MOE-MK/turbo-frames/docs/img/og.png

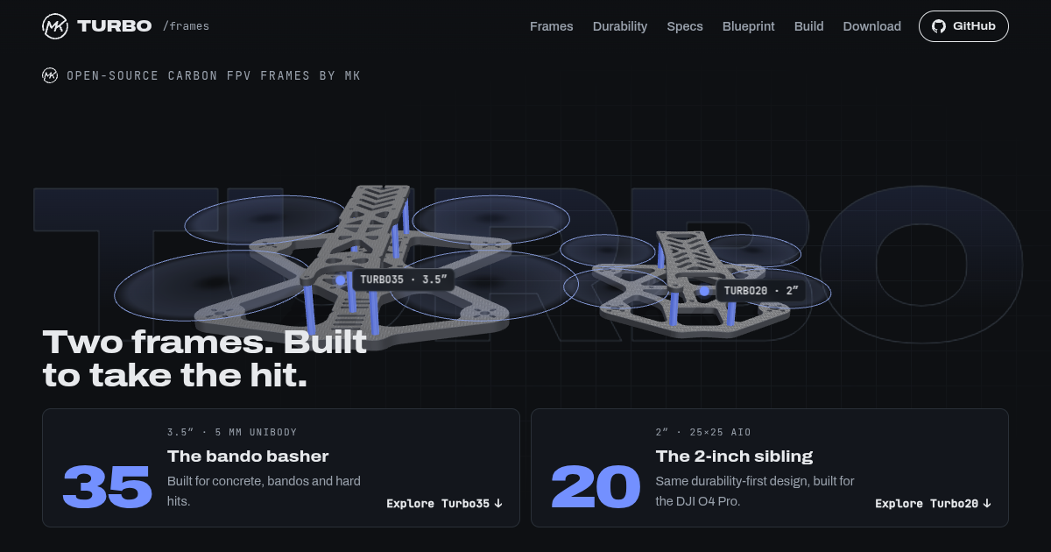
docs/img/og.png
