MOE-MK/turbo-frames/BOM.md

# Bill of Materials

## Turbo35

**Frame weight:** 75 g · **With hardware:** 85 g

| Qty | Part |
|---|---|
| 1 | 5.0 mm base plate (T700), [`dxf/Turbo35_Bottom.dxf`](dxf/Turbo35_Bottom.dxf) |
| 1 | 3.0 mm top plate (T700), [`dxf/Turbo35_Top.dxf`](dxf/Turbo35_Top.dxf) |
| 10 | M2 × 25 mm standoffs |
| 20 | M2 × 8 mm button-head screws |
| 20 | M2 × 10 mm button-head screws |
| 4 | M2 × 20 mm button-head screws |
| 12 | M2 nuts (black) |

**Hole reference (bottom plate)**
- Motor mounts: slotted, fit 9×9 and 12×12 motor patterns (M2)
- Center stack: 20×20 (M2), 30.5×30.5 (3.5 mm holes, M3 clearance), 25.5×25.5 rotated 45° (M2)
- Rear mounting area: 20×20 and 25.5×25.5 (M2)
- Antenna: slot at the back of the top plate

**3D-printed parts:** see [`prints/`](prints/)

## Turbo20

| Qty | Part |
|---|---|
| 1 | 3 mm bottom plate (T700), [`dxf/Turbo20_Bottom.dxf`](dxf/Turbo20_Bottom.dxf) |
| 1 | 2 mm top plate (T700), [`dxf/Turbo20_Top.dxf`](dxf/Turbo20_Top.dxf) |
| — | M2 standoffs and hardware (list coming soon) |

**Recommended electronics:** 12xx–14xx motors at 4000–6000 KV on 4S HV 400–850 mAh.
**Designer's build:** 1303.5 5500 KV motors on a 4S 450 mAh HV pack.

**Hole reference (bottom plate)**
- Motor mounts: 9×9 (M2)
- Stack: 25.5×25.5 rotated 45° (M2), for the 25×25 AIO with the VTX stacked on top
