MOE-MK/turbo-frames/docs/files/dxf/Turbo35_Bottom.dxf

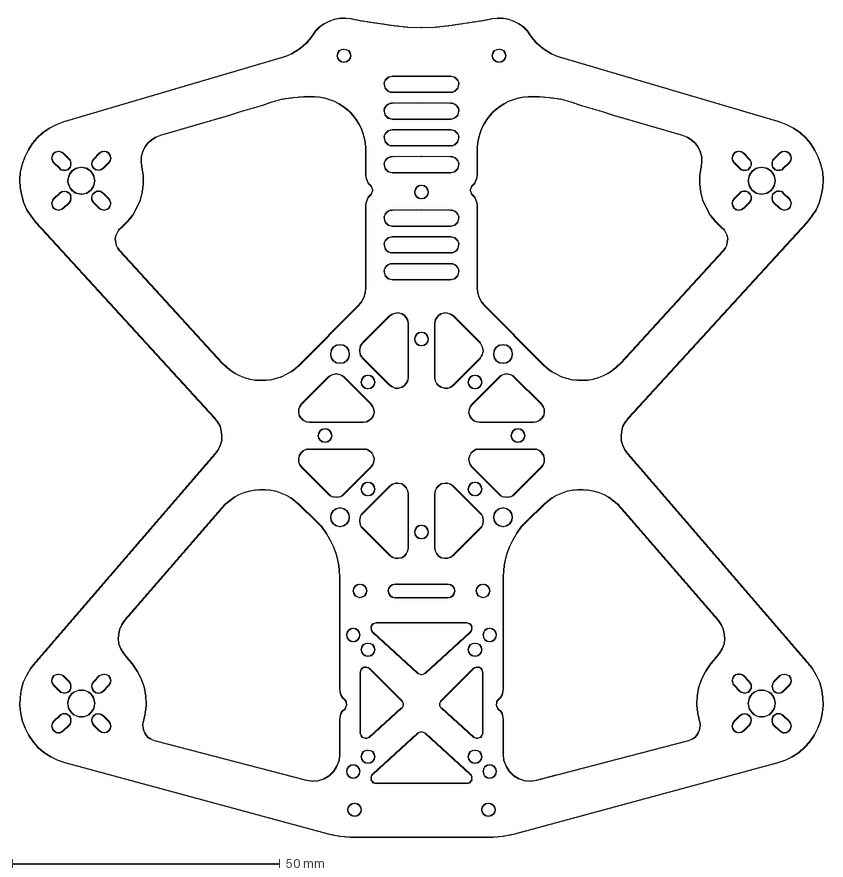
[picture p5: CAD file, 2026-09-28]
docs/files/dxf/Turbo35_Bottom.dxf
151.5 x 153.4 mm
