MOE-MK/turbo-frames/docs/files/prints/o3-cam.stl

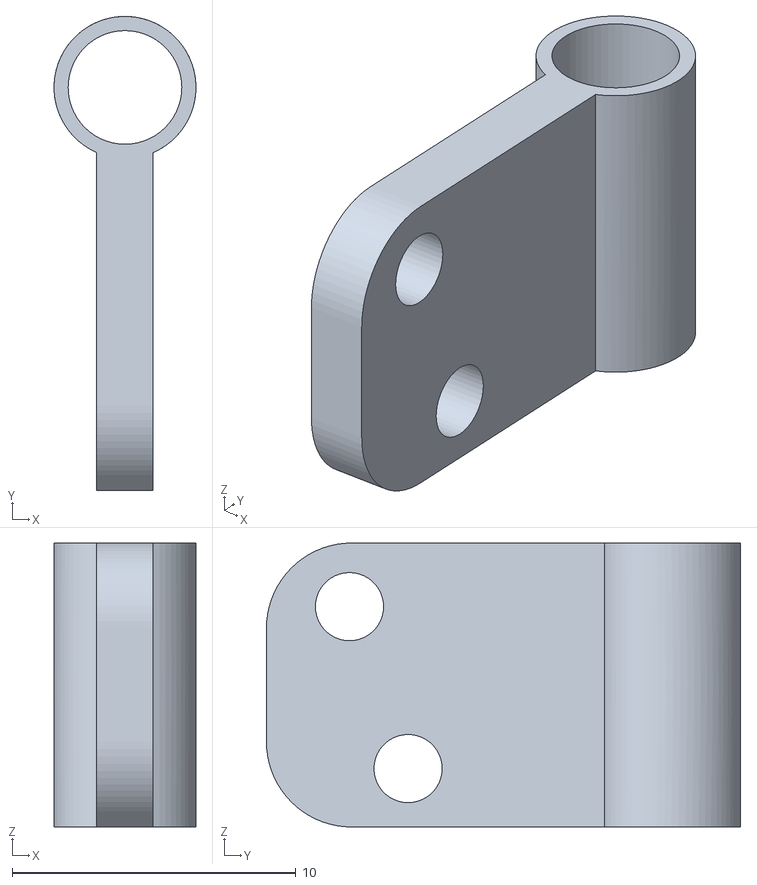
[picture p6: CAD file, 2026-09-28]
docs/files/prints/o3-cam.stl
5.00 x 16.7 x 10.0
