MOE-MK/turbo-frames/prints/turbo35/turbo-35-battery-pad.3mf

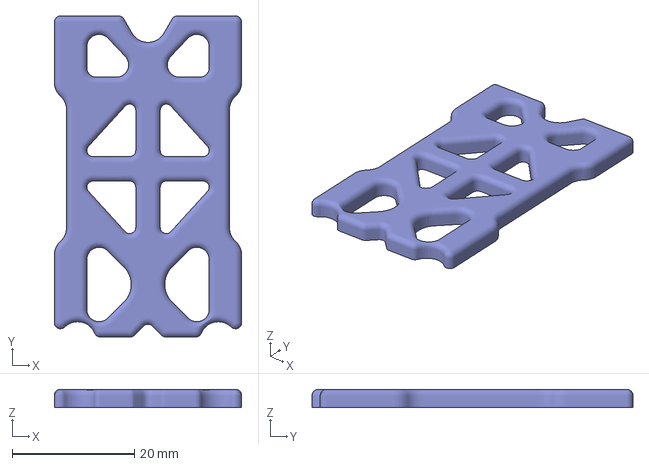
[picture p7: CAD file, 2026-09-28]
prints/turbo35/turbo-35-battery-pad.3mf
30.6 x 52.5 x 3.00 mm
