MOE-MK/turbo-frames/docs/files/dxf/Turbo20_Top.dxf

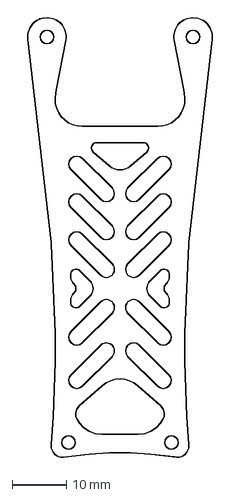
[picture p8: CAD file, 2026-09-28]
docs/files/dxf/Turbo20_Top.dxf
34.5 x 81.6 mm
