MOE-MK/turbo-frames/docs/files/prints/hdzero_nano_90_camera_mount.3mf

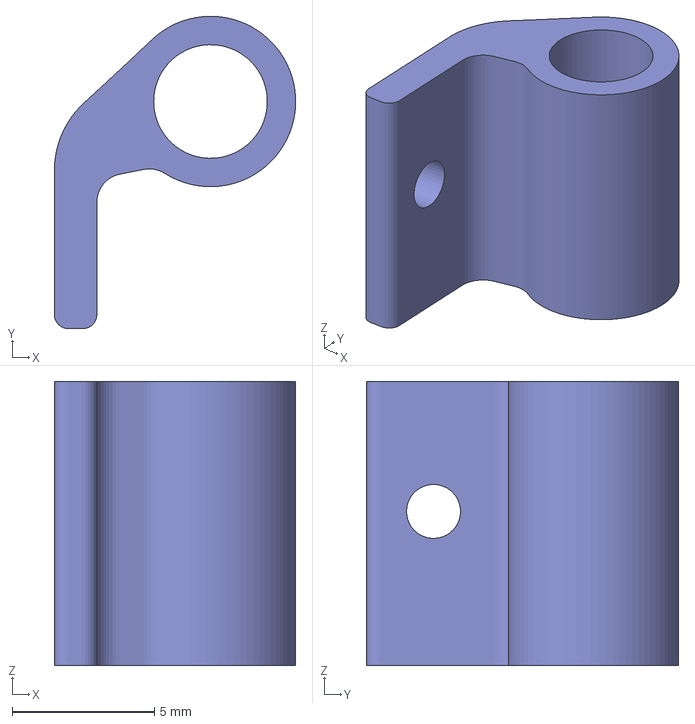
[picture p9: CAD file, 2026-09-28]
docs/files/prints/hdzero_nano_90_camera_mount.3mf
8.50 x 11.0 x 10.0 mm
