MOE-MK/turbo-frames/docs/files/dxf/Turbo20_Bottom.dxf

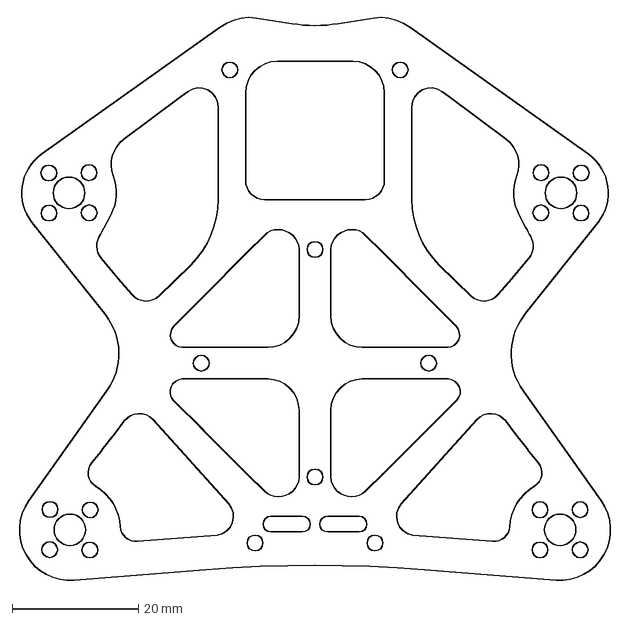
[picture p10: CAD file, 2026-09-28]
docs/files/dxf/Turbo20_Bottom.dxf
94.7 x 89.6 mm
