MOE-MK/turbo-frames/docs/files/prints/o4-bumper.3mf

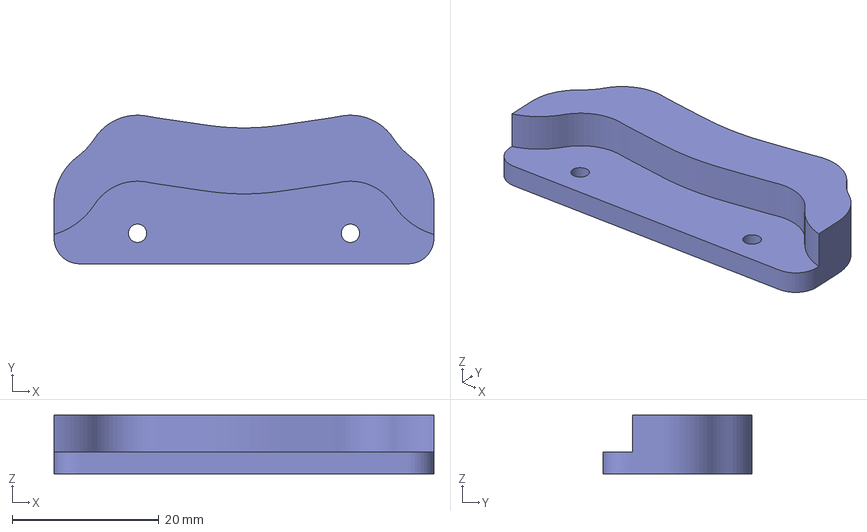
[picture p11: CAD file, 2026-09-28]
docs/files/prints/o4-bumper.3mf
51.8 x 20.3 x 8.00 mm
