MOE-MK/turbo-frames/prints/turbo35/dji-o3-camera-mount.3mf

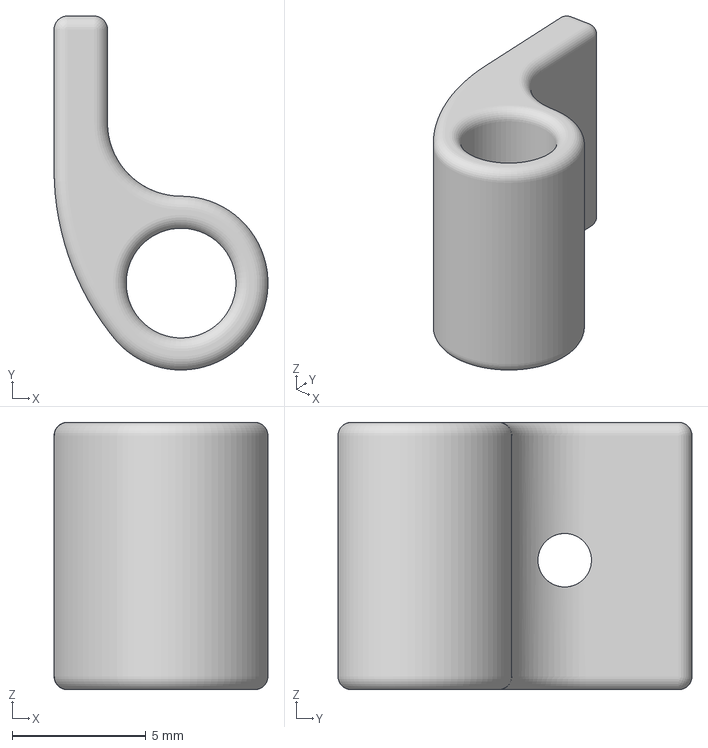
[picture p12: CAD file, 2026-09-28]
prints/turbo35/dji-o3-camera-mount.3mf
8.00 x 13.2 x 10.0 mm
