MOE-MK/turbo-frames/docs/files/dxf/Turbo35_Top.dxf

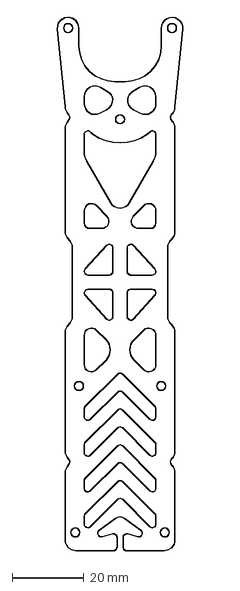
[picture p13: CAD file, 2026-09-28]
docs/files/dxf/Turbo35_Top.dxf
35.2 x 149.3 mm
