MOE-MK/turbo-frames/prints/turbo35/o4-pro-mount-right.3mf

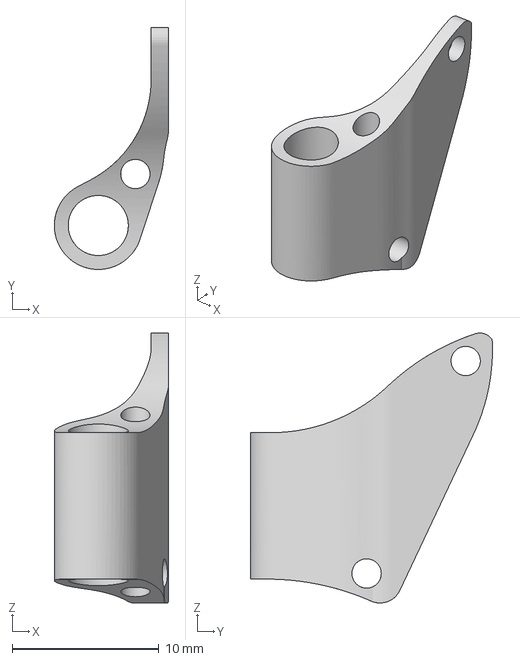
[picture p14: CAD file, 2026-09-28]
prints/turbo35/o4-pro-mount-right.3mf
7.80 x 16.5 x 18.4 mm
