MOE-MK/turbo-frames/docs/files/prints/turbo-antenna-mount.stl

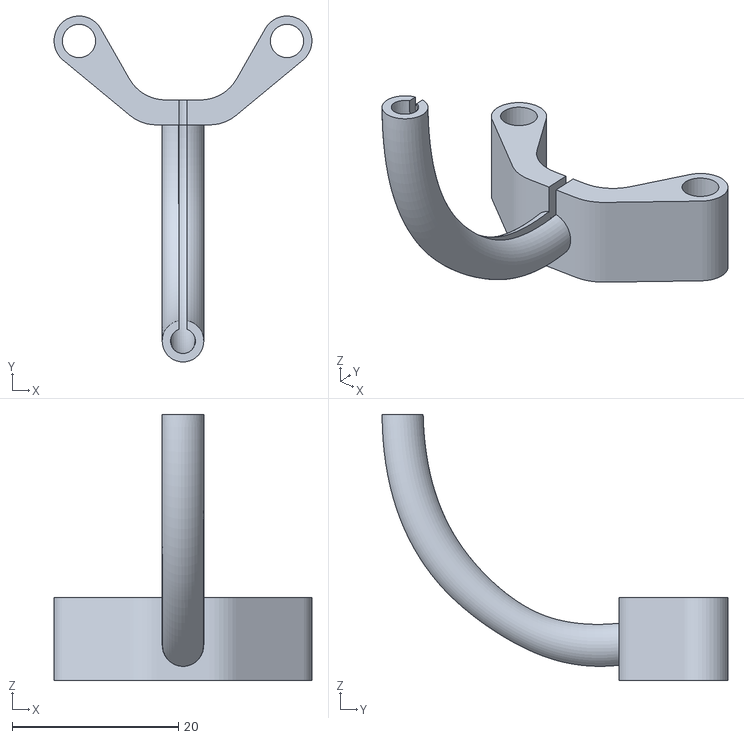
[picture p15: CAD file, 2026-09-28]
docs/files/prints/turbo-antenna-mount.stl
31.0 x 41.6 x 32.0
