MOE-MK/turbo-frames/prints/turbo35/bumper.stl

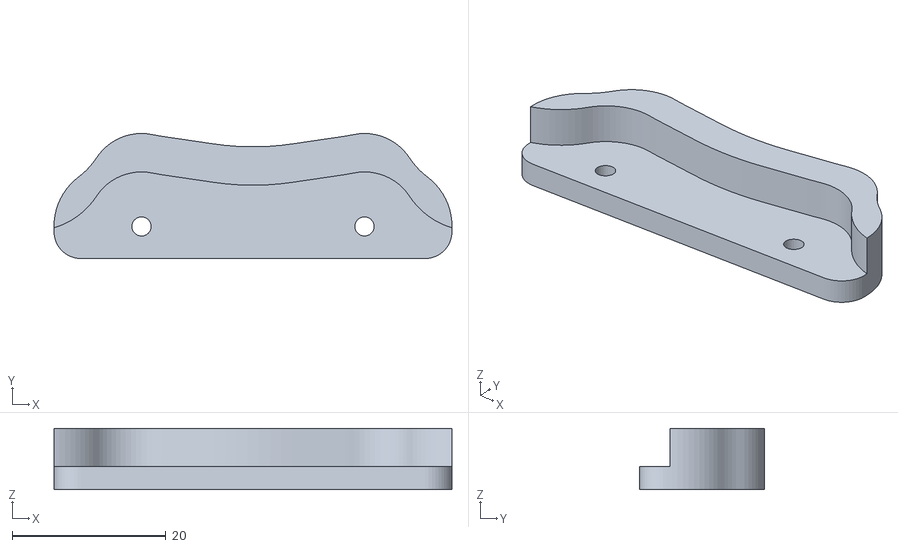
[picture p16: CAD file, 2026-09-28]
prints/turbo35/bumper.stl
51.8 x 16.3 x 8.00
