MOE-MK/turbo-frames/docs/files/prints/universal-cam.stl

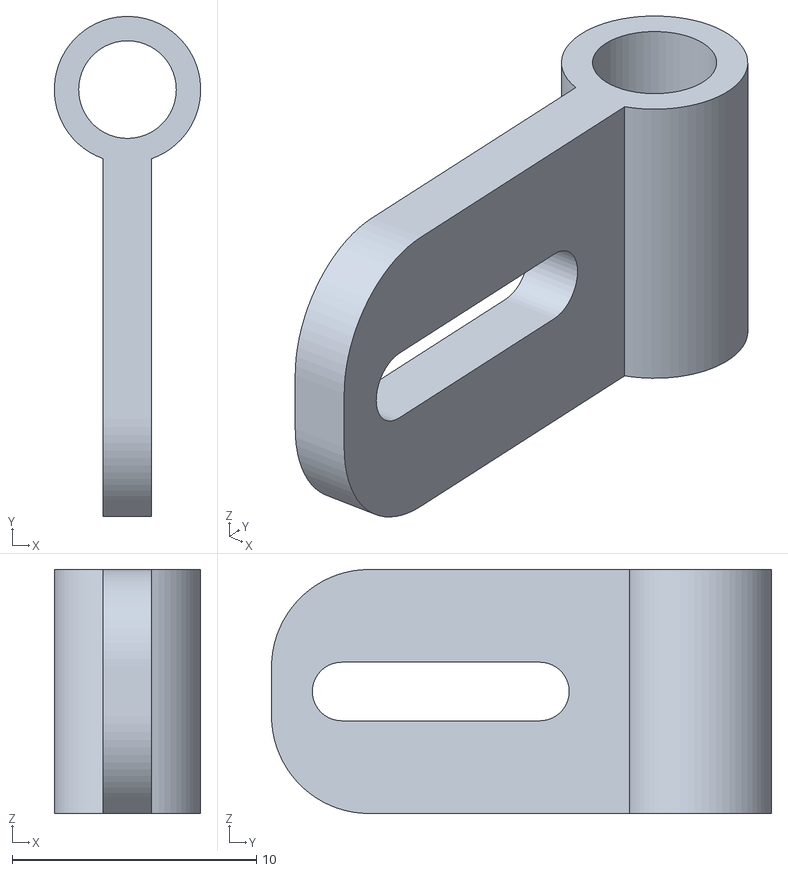
[picture p17: CAD file, 2026-09-28]
docs/files/prints/universal-cam.stl
5.99 x 20.5 x 10.0
