MOE-MK/turbo-frames/docs/files/prints/elrs-antenna.3mf

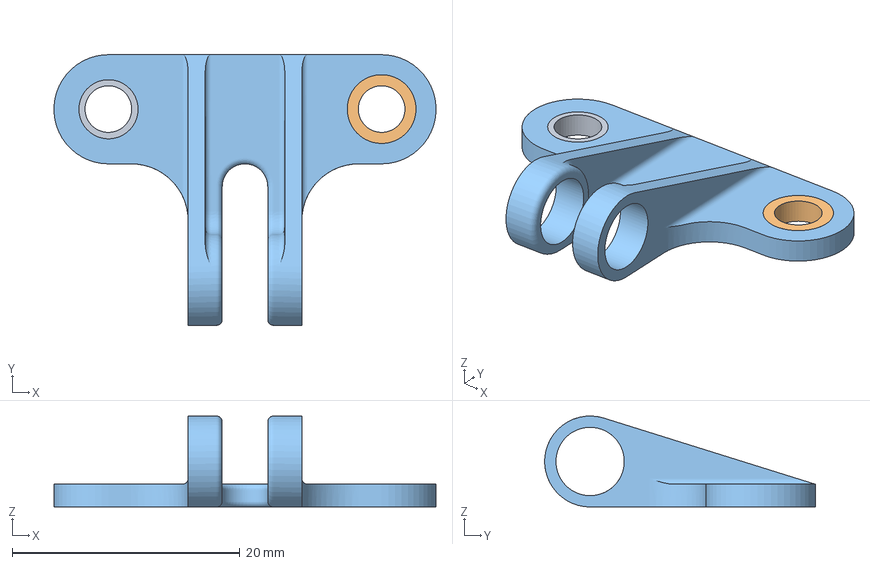
[picture p18: CAD file, 2026-09-28]
docs/files/prints/elrs-antenna.3mf
33.6 x 23.8 x 8.00 mm
cfpv_elrs_ant_support
