MOE-MK/turbo-frames/prints/turbo35/turbo-gopro.stl

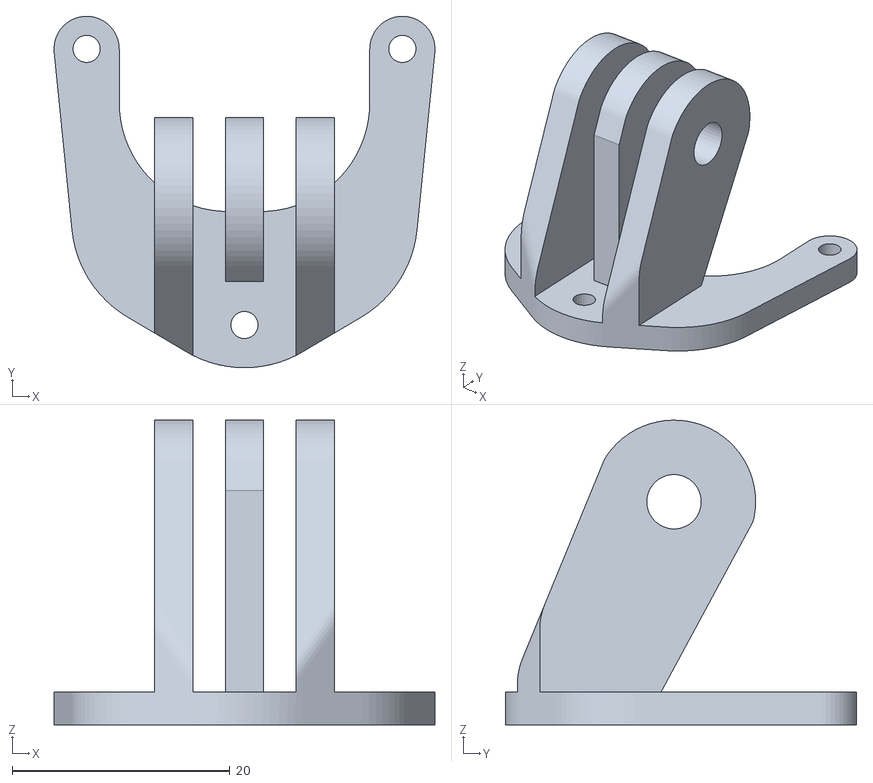
[picture p19: CAD file, 2026-09-28]
prints/turbo35/turbo-gopro.stl
35.0 x 32.3 x 28.0
