MOE-MK/turbo-frames/prints/turbo35/turbo_16mm_fpv_cam.stl

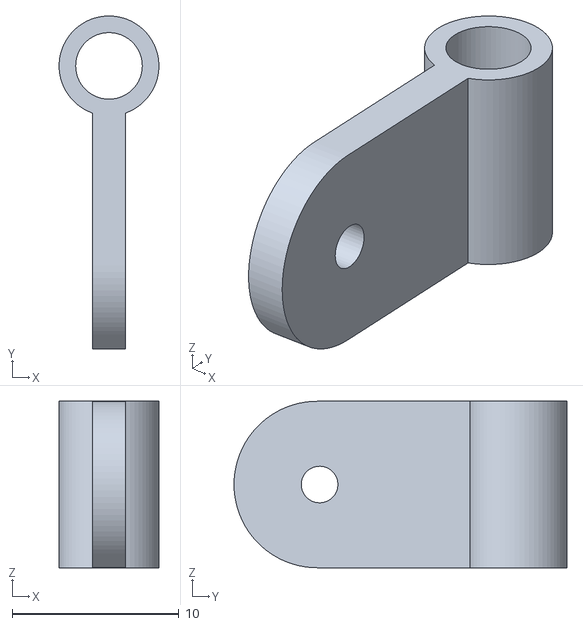
[picture p20: CAD file, 2026-09-28]
prints/turbo35/turbo_16mm_fpv_cam.stl
5.99 x 20.0 x 10.0
