MOE-MK/turbo-frames/(list of files, cad)

Other CAD files:
prints/turbo35/o4-pro-mount-left.3mf
docs/files/prints/o4-pro-mount-left.3mf
