MOE-MK/turbo-frames/(commit log)

2026-09-28 Initial release: Turbo35 and Turbo20 frames
    DXFs, renders, BOM, and CC BY-SA 4.0 license.
    [Turbo20_Bottom.dxf, Turbo20_Top.dxf, Turbo35_Bottom.dxf, Turbo35_Top.dxf]
2026-09-28 Add interactive 3D website, real Turbo35 hardware list, and 3D-printed parts
    - docs/: GitHub Pages site with three.js models built from the DXF geometry,
    scroll-driven assembly, stack/motor highlights, SVG blueprint viewer,
    build checklist, and downloads (libraries vendored, no CDN)
    - BOM: Turbo35 hardware list and weights from the designer's notes
    - prints/: Turbo35 printed parts (CC BY-NC 4.0, as on Printables)
    [Turbo20_Bottom.dxf, Turbo20_Top.dxf, Turbo35_Bottom.dxf, Turbo35_Top.dxf, bumper.stl, dji-o3-camera-mount.3mf, elrs-antenna.3mf, hdzero_nano_90_camera_mount.3mf]
2026-09-28 Add two-frame lineup intro, bando basher positioning, and Turbo20 electronics
